jacgoudsmit/Propeddle/Hardware/Kicad/Plot/Schematic.pdf

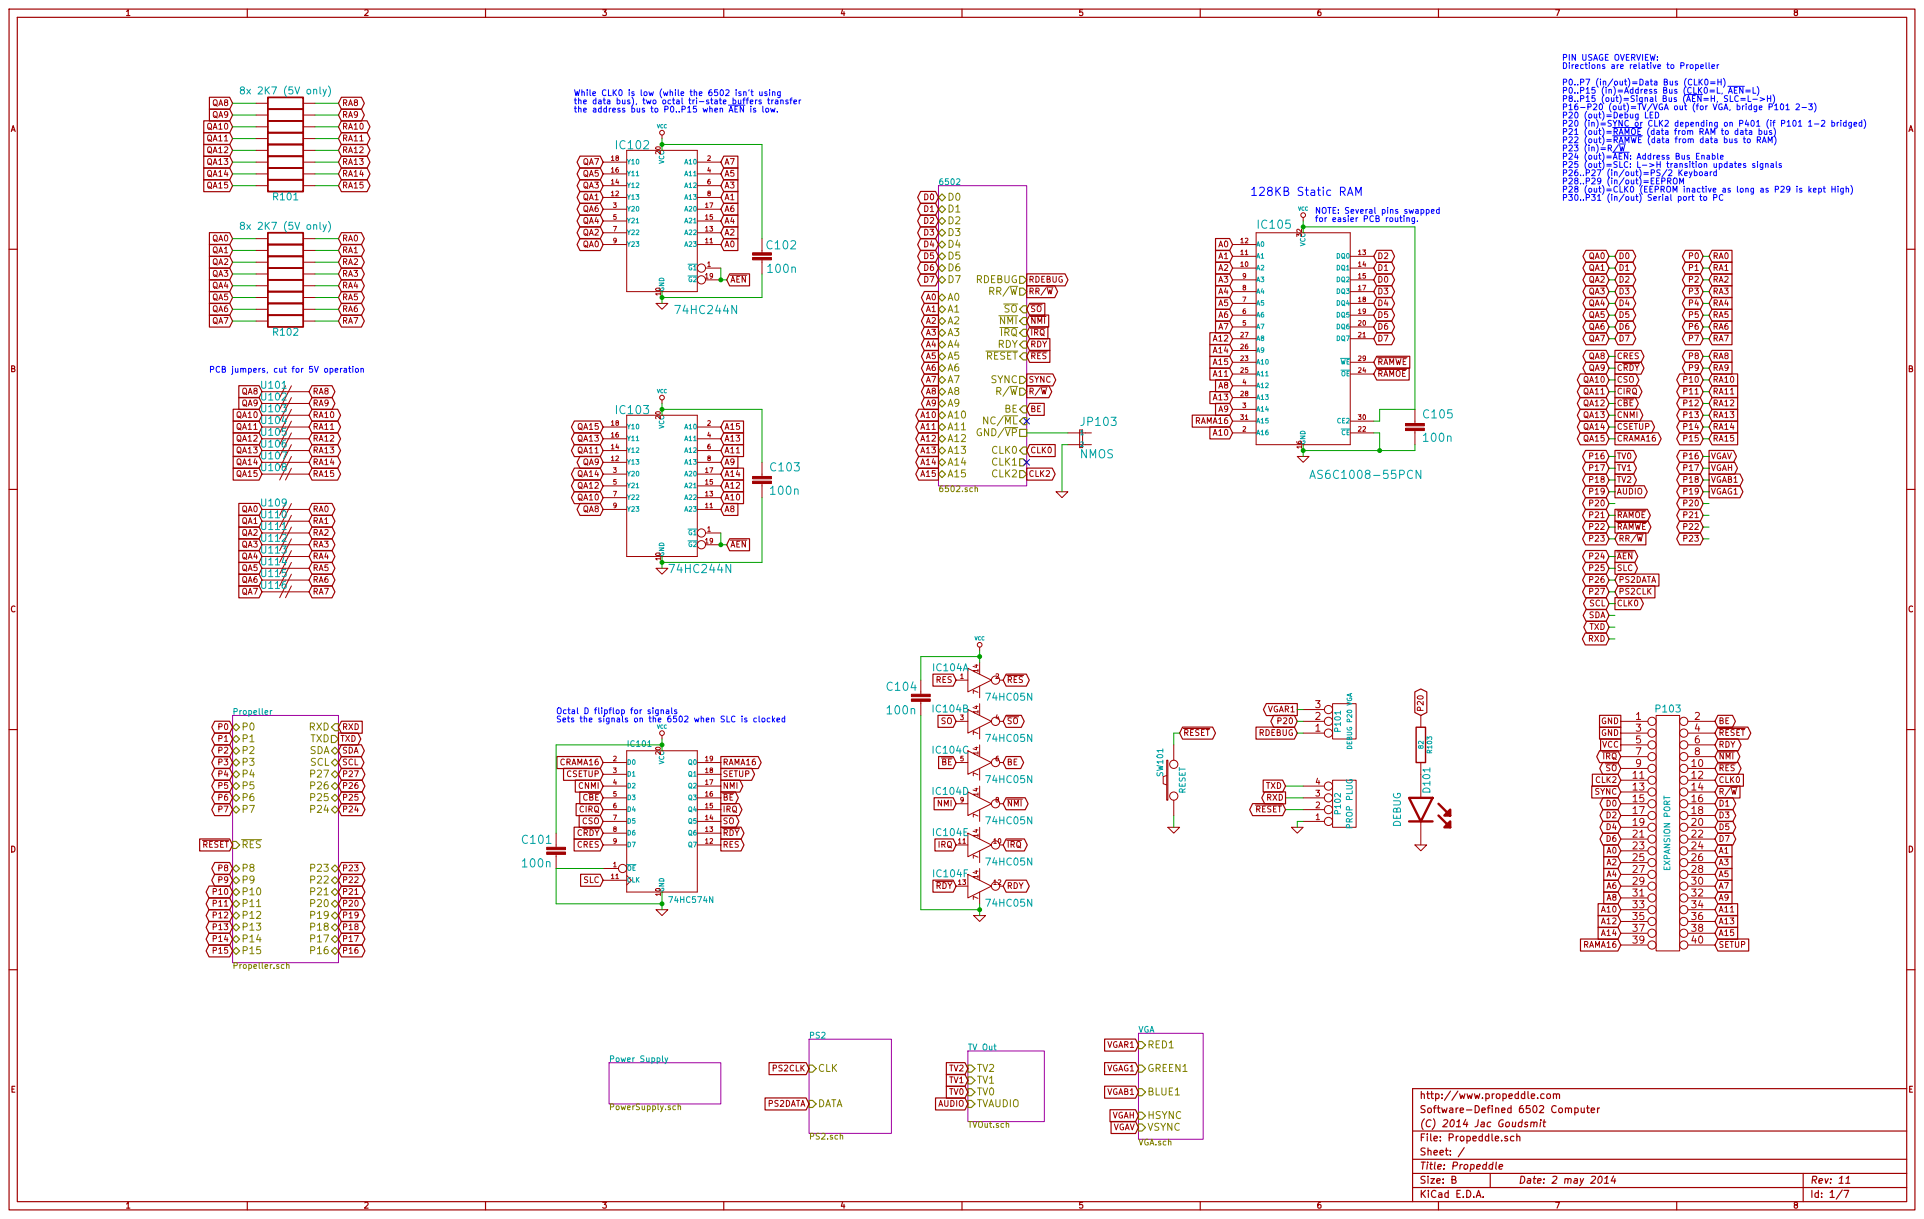
[picture p1: page 1]

P0..P7 (in/out)=Data Bus (CLK0=H)
P0..P15 (in)=Address Bus (CLK0=L, AEN=L)
P8..P15 (out)=Signal Bus (AEN=H, SLC=L->H)
P16-P20 (out)=TV/VGA out (for VGA, bridge P101 2-3)
P20 (out)=Debug LED
P20 (in)=SYNC or CLK2 depending on P401 (if P101 1-2 bridged)
P21 (out)=RAMOE (data from RAM to data bus)
P22 (out)=RAMWE (data from data bus to RAM)
P24 (out)=AEN: Address Bus Enable
P25 (out)=SLC: L->H transition updates signals
P26..P27 (in/out)=PS/2 Keyboard
P28..P29 (in/out)=EEPROM
P28 (out)=CLK0 (EEPROM inactive as long as P29 is kept High)

While CLK0 is low (while the 6502 isn't using
the data bus), two octal tri-state buffers transfer
the address bus to P0..P15 when AEN is low.

P30..P31 (in/out) Serial port to PC
D0 D1 D2 D3 D4 D5 D6 D7 QA8 QA9 QA10 QA11 QA12 QA13 QA14 QA15 P16 P17 P18 P19 P20 P21 P22 P23 P24 P25 P26 P27 SCL SDA

VCC
NOTE: Several pins swapped

RDEBUG
NMI SO
NC/ML BE RESET RDY

PCB jumpers, cut for 5V operation

Octal D flipflop for signals
Sets the signals on the 6502 when SLC is clocked

TV Out TVOut.sch TV2 TV1 TV0 TVAUDIO

http://www.propeddle.com
Software-Defined 6502 Computer
(C) 2014 Jac Goudsmit
File: Propeddle.sch
Sheet: /
Title: Propeddle
KiCad E.D.A.

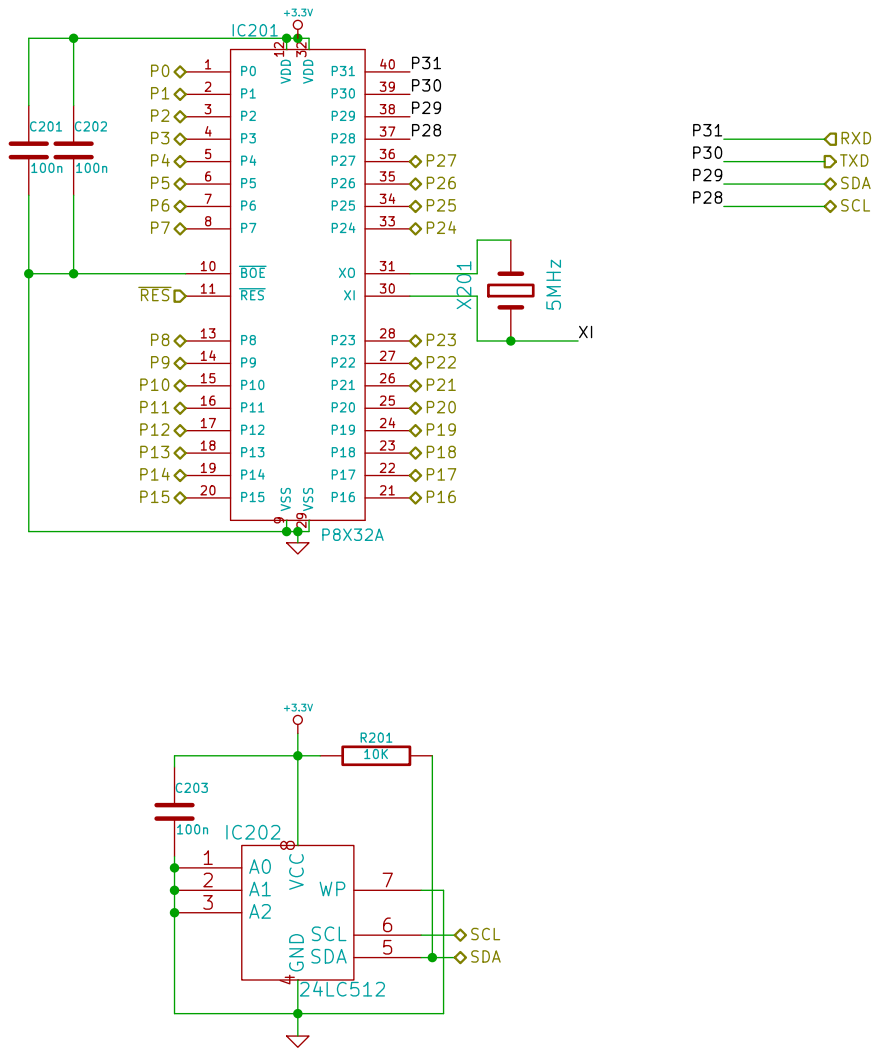
[picture p2: page 2]

http://www.propeddle.com
Software-Defined 6502 Computer
(C) 2014 Jac Goudsmit
File: Propeller.sch
Sheet: /Propeller/
Title: Propeddle

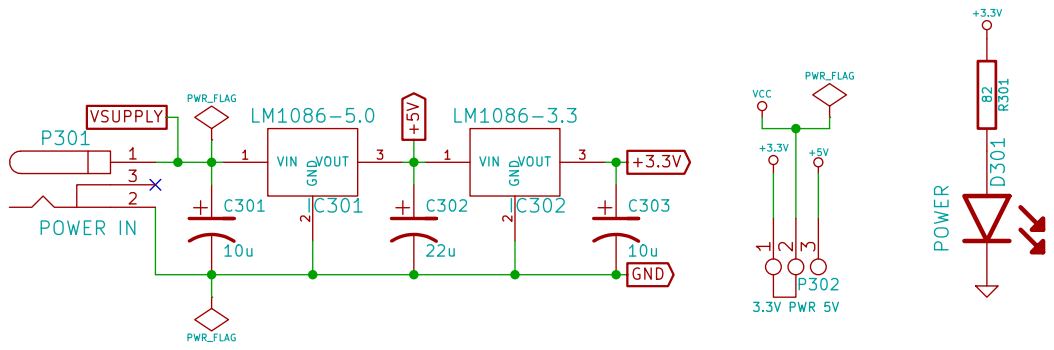
[picture p3: page 3]

http://www.propeddle.com
Software-Defined 6502 Computer
(C) 2014 Jac Goudsmit
File: PowerSupply.sch
Sheet: /Power Supply/
Title: Propeddle

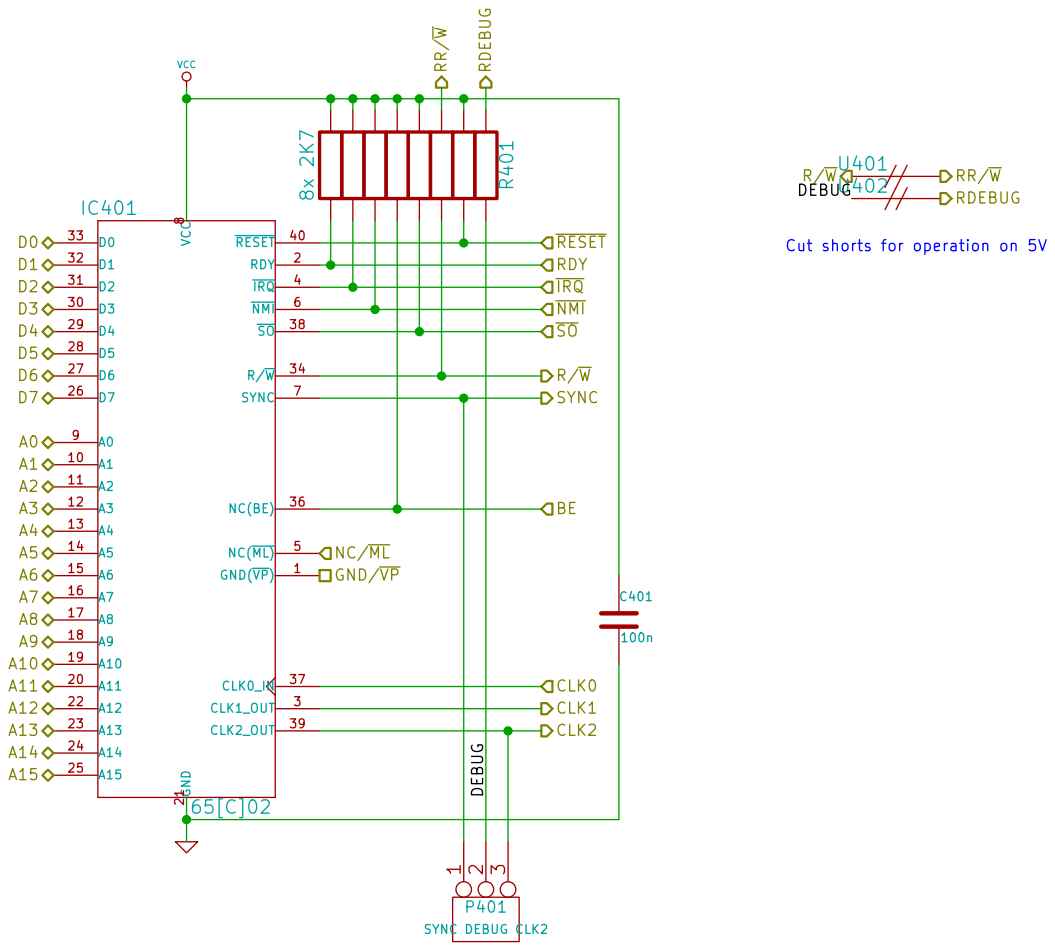
[picture p4: page 4]

Cut shorts for operation on 5V DEBUG

http://www.propeddle.com
Software-Defined 6502 Computer
(C) 2014 Jac Goudsmit
Title: Propeddle File: 6502.sch Sheet: /6502/

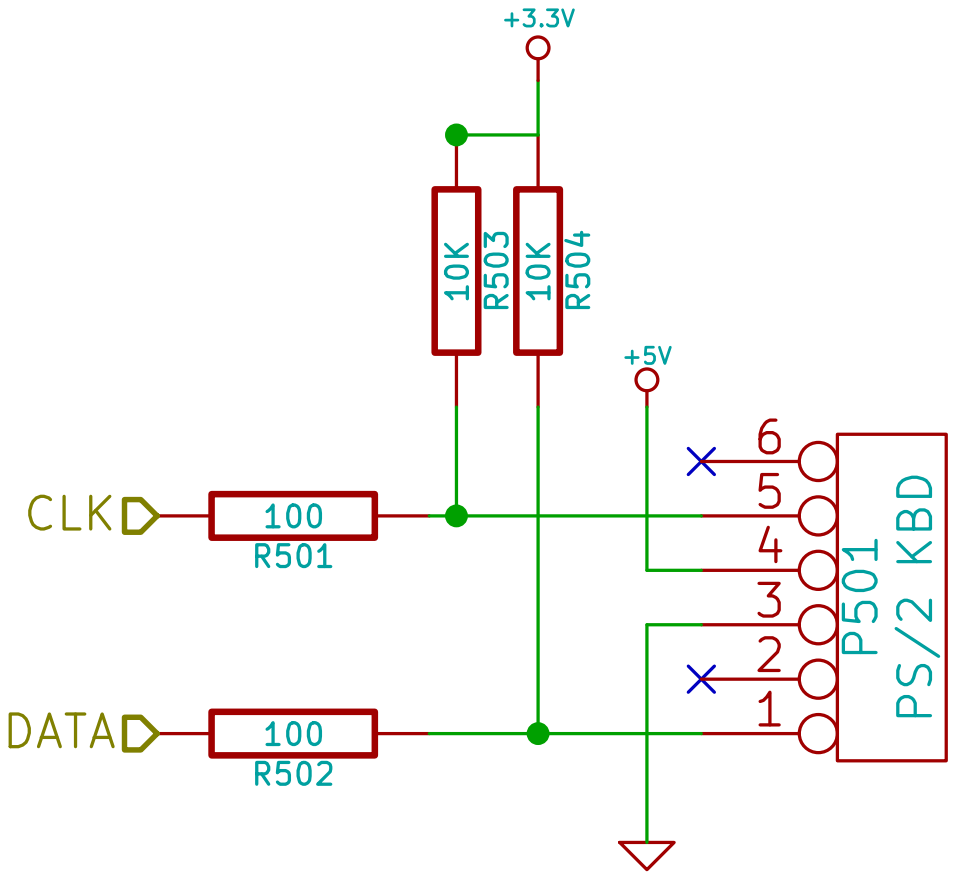
[picture p5: page 5]

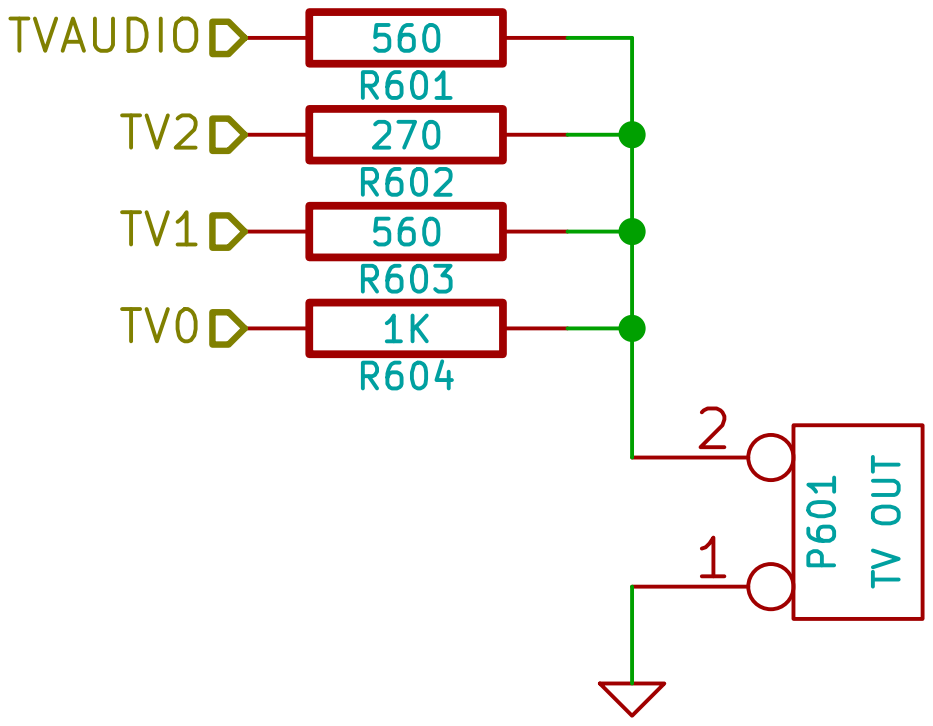
[picture p6: page 6]

http://www.propeddle.com
Software-Defined 6502 Computer
(C) 2014 Jac Goudsmit
File: TVOut.sch
Sheet: /TV Out/
Title: Propeddle

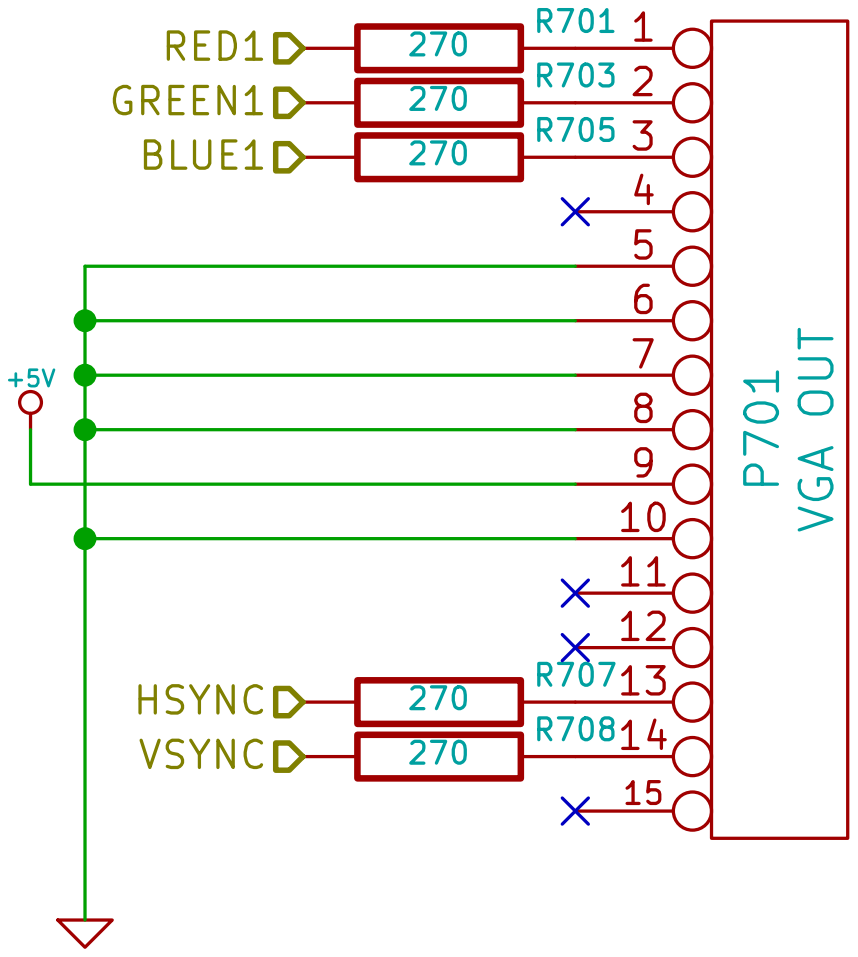
[picture p7: page 7]

http://www.propeddle.com 123456789
270 RED1 GREEN1 BLUE1 HSYNC
