jacgoudsmit/Propeddle/Hardware/Kicad/ENG_CD_1825027_G4.pdf

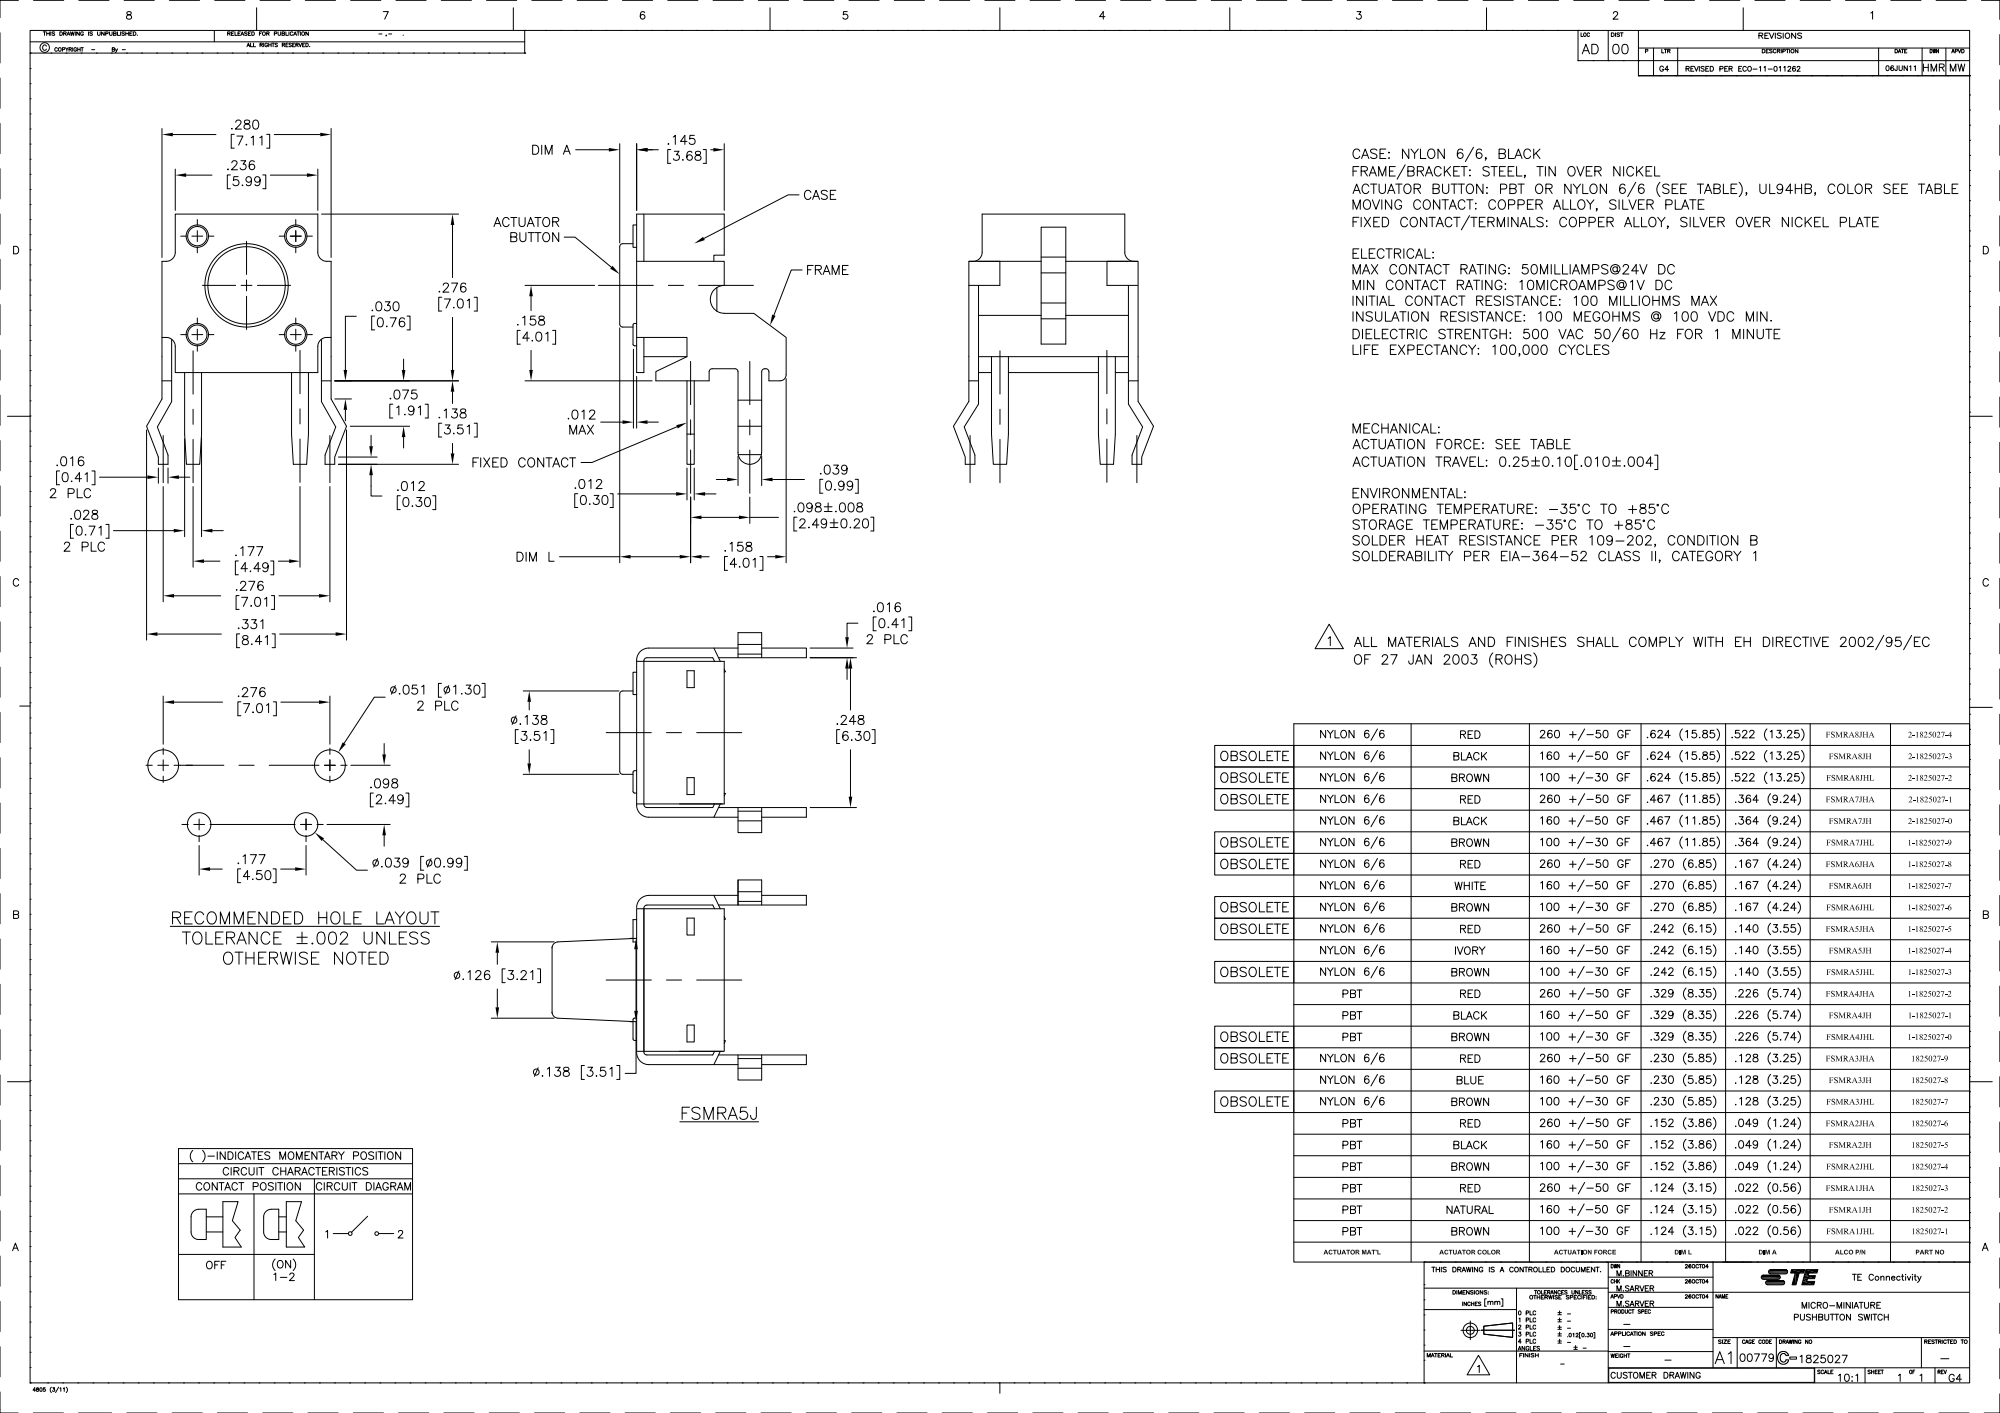
[picture p8: page 1]
