jacgoudsmit/Propeddle/Hardware/Kicad/Plot/PCB1.pdf

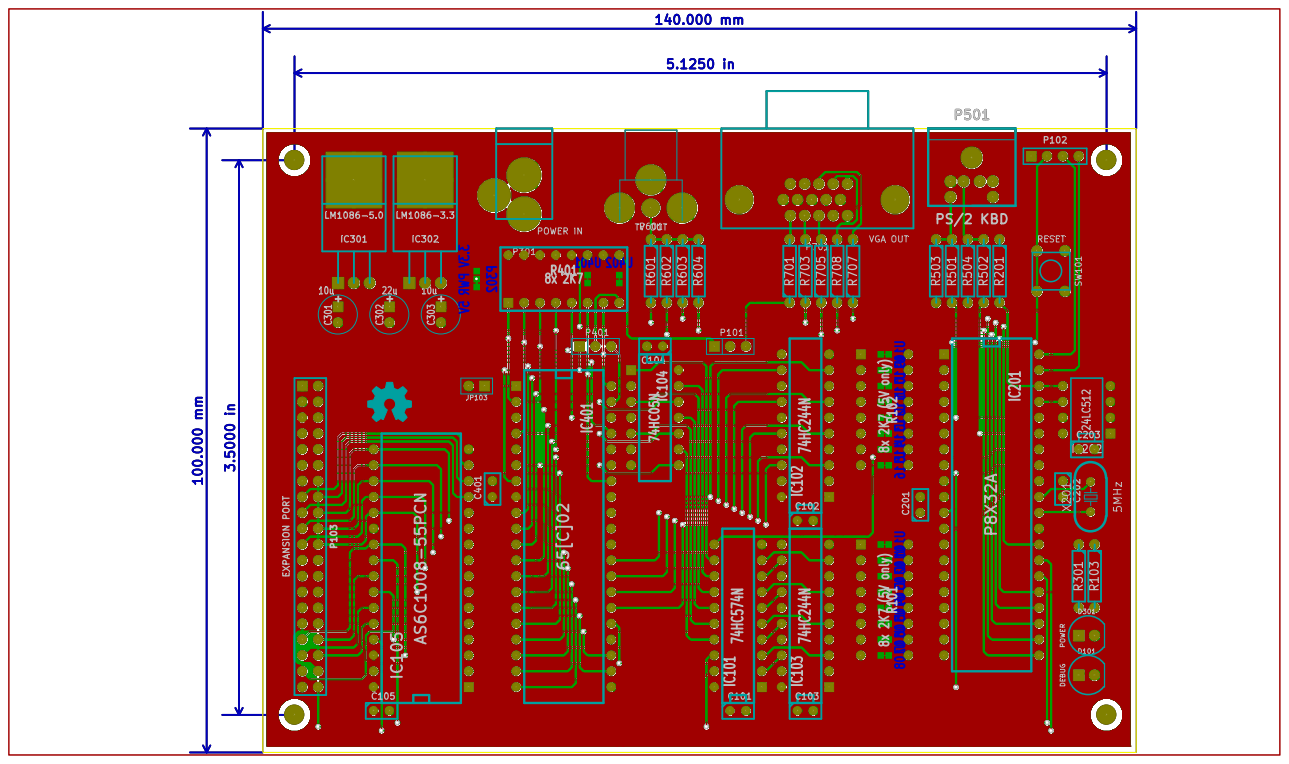
[picture p16: page 1]
