jacgoudsmit/Propeddle/Software/propeddle100.cfg

# propeddle100.cfg
    clkfreq: 100000000
    clkmode: XTAL1+PLL16X
    baudrate: 115200
    rxpin: 31
    txpin: 30
    tvpin: 16   # only used if TV_DEBUG is defined
