jacgoudsmit/Propeddle/(commit log)

2012-08-11 Starting rewrite of Propeddle software in C using SimpleIDE 0.8.3.
    The current implementation declares (pretty much) the (entire) API in the propeddle.h file but only implements the LED functions for now.
    The current test program only blinks the LED, to test the control cog.
    [propeddle100.cfg, propeddle80.cfg]
2012-08-16 Bugfix: Adding code to set up a stack for the control cog
    [p6502control.h, propeddle.c]
2012-08-16 Checking in some small bugfixes that I forgot to check in earlier
    [PropeddleTest.spin]
2013-03-09 Committing (non-working) changes before switching back to Spin
    The reason I'm abandoning the C version of the project for now, is that
    a lot of inline assembly code (such as a lot of instructions in the
    .cogc module) currently don't get compiled/assembled correctly: The
    assembler doesn't translate immediate values correctly if they refer to
    cog addresses (except for JMP / CALL instructions for which it follows a
    different execution path).
    Also, data directives that store pointers to other items in th same cog
    currently don't generate the correct addresses.
    The problem is caused by the fact that the GNU tools insist on using
    byte-based addressing, and the current version of the Propeller
    as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
    [main.c, p6502control.c, p6502control.h, p6502features.h, propeddle.c, propeddle.h]
2013-06-28 Adding updated Spin code
    This version of the Spin source code now includes all the modules that
    are needed, they just need to be "tied together". The demo application
    still controls the 6502 via spin and basically shows what I had at the
    2013 Bay Area Maker Faire Bring-a-hack dinner. But in theory there
    should be enough there now to use the Hub module to map the demo code
    and the video buffer, the Trace buffer to show what's going on, and the
    Control module to single-step or run the demo code. The RAM module
    should also be usable but nothing is tested yet. This is getting really
    close to being able to running at full speed!
2013-06-28 Updating the C code
    The C code depends on the new .pasm directive in the GCC compiler and it
    looks like it compiles correctly, but because the .pasm directive is
    experimental in the Propeller GCC compiler, there's a good chance that
    code gets compiled incorrectly even though it's logically correct. For
    now I don't want to deal with the possible debugging issues that might
    be involved with that, so I'll just check this in by way of archiving
    it. The most up-to-date software will be in the software/spin directory
    from this point on. Once I get the spin/pasm based code to work
    reliably, I will translate it to C/pasm again, for the purpose of
    generating code that's more flexible (because C has a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
    [demo.c, main.c, p6502_control.h, p6502_feature.h, p6502_hw.h, p6502control.c, p6502control.h, propeddle.c]
2013-07-02 IT RUNS!
    Got the PASM code running but have to deal with some timing problem: At
    80 cycles, the hub access and trace cogs apparently pick up the address
    bus too late or too early, seeing FDF0 instead of FFF0. At 88 cycles it
    works fine. At values in between, the loop runs out of time (hangs) so
    the code needs to be slightly more complicated that just taking 80 as
    minimum and allowing all values that are greater.
    At 88 cycles or higher, this works! Using this configuration, the test
    program tests the control cog, the hub access cog and the trace cog. It
    also tests that the 6502 accesses the RAM chip in read and write mode
    correctly.
    The timing problem can probably be fixed by using a cog time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
    [PropeddleTest.spin]
2013-07-07 Partial fix for timing of initial loop in Control module
    Instead of jumping into the middle of the loop and trying to get the
    timing right for the first loop, the code now falls through to the
    WAITCNT at the beginning of the loop, and makes sure that the cog is
    synchronized to the hub. Now at least the code doesn't freeze up when
    it's set to 80 cycles and all control cog loops should have the exact
    same timing if the cycle time is a multiple of 16, but I still have to
    set up my logic analyzer to find out why I'm getting completely wrong
    trace data at 80 cycles, while at 88 cycles, everything appears to work
    as expected...
    [PropeddleTest.spin]
2014-02-20 Checking in Kicad schematic
    Generated Kicad schematic with eagle2kicad.ulp from the circuitbee
    website, after modifying the ulp script so that g_Fact is set to 254*32
    instead of 254 (based on a tip from a web page called "unit issue with
    eagle2kicad.ulp"
    [Propeddle.sch]
2014-02-20 Kicad schematics
    Let's try that again, somehow all the parts got mangled on the previous
    version.
    [Propeddle.sch]
2014-02-23 Adding .gitignore in Kicad directory
2014-02-23 Some work on the hardware design in Kicad
    Eliminated a number of errors in schematic; created module for expansion
    port, other changes
    [Propeddle.kicad_pcb, Propeddle.sch]
2014-02-24 More updates to schematic
    I decided to keep working on the schematic and PCB layout in Kicad until
    I have the current schematic (Rev. 8A which needed a Propeller Platform
    motherboard and a modified VGA/AV module) implemented as Kicad files,
    and it completely matches what I have in Eagle. After that, I'll take
    the next step which is to design a new PCB with all the necessary
    hardware. That way, I can learn Kicad and focus on problems caused by
    the imperfect export script that I used to convert the Eagle design.
    Debugging things like short-circuits caused by Kicad interpreting two
    bus connections in the same place in a different way than Eagle, is much
    easier when the schematic is small and fa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
    [Propeddle.dsn, Propeddle.kicad_pcb, Propeddle.sch]
2014-03-09 Re-created exact component placements from Eagle
    [Propeddle.kicad_pcb]
2014-03-16 Finished re-designing Propeddle Rev.8A PCB
    The Kicad PCB design is now virtually identical to the Rev. 8 PCB that I
    sold as a kit, except the one missing trace on that PCB is now present.
    [Propeddle.kicad_pcb, Propeddle.sch]
2014-04-08 Completed design of "all-in-one" schematic/PCB
    Some of the important changes:
    - Everything on one PCB including Propeller, connectors and power
    supply. The only thing missing is the serial-to-USB converter.
    - Added inverters: the signals (~IRQ, ~NMI, ~RES, ~SO and RDY) are now
    connected via open-drain inverters which eliminates all diodes in the
    old schematic.
    - The old SEL0 and SEL1 are now replaced by BE (via open-drain inverter)
    and SETUP. These signals will make it possible to initialize expansion
    hardware via the data bus.
    - Added power supply, Propeller, connectors for keyboard, mouse, TV and
    power (and added their documentation)
    - The expansion port was redesigned (Sorry, future expan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
    [6502.sch, PS2.sch, PowerSupply.sch, Propeddle.dsn, Propeddle.kicad_pcb, Propeddle.sch, Propeller.sch, TVOut.sch]
2014-04-18 Schematic updates
    [6502.sch, PS2.sch, PowerSupply.sch, Propeddle.kicad_pcb, Propeddle.sch, Propeller.sch, TVOut.sch, VGA.sch]
2014-04-18 Schematic Rev. 11
    Added LEDs; some minor other modifications
    [6502.sch, PS2.sch, PowerSupply.sch, Propeddle.kicad_pcb, Propeddle.sch, Propeller.sch, TVOut.sch, VGA.sch]
2014-04-23 Schematic Rev. 11 update
    Replaced 74HC06N by 74HC05N
    [6502.sch, PS2.sch, PowerSupply.sch, Propeddle.kicad_pcb, Propeddle.sch, Propeller.sch, TVOut.sch, VGA.sch]
2014-04-23 SerInTVOut bugfix
    The FullDuplexSerial rxcheck function checks for an incoming character
    and removes it from the queue, the code assumed that it did the same as
    the PS/2 keyboard code so the user had to type everything twice when
    using the terminal.
    [SerInTVOut.spin]
2014-04-23 PCB Rev. 11
    Adjusted location of labels on big chips
    [Propeddle.kicad_pcb]
2014-04-26 Updated software to support hardware Rev. 11
    Currently only the Spin version of the demo program works, the control
    cog apparently doesn't.
    [PropeddleHardware.spin, PropeddleTest.spin]
2014-04-26 Fixed control cog to work on hardware Rev. 11
    And guess what... with my current wire-wrap setup on a Parallax USB
    Proto Board, I can run the main loop at 80 cycles now! (With the Rev. 8
    hardware, the program worked at 88 cycles (909kHz) but not at 80 cycles
    (1MHz).
    [PropeddleTest.spin]
2014-05-02 Moving databus behind resistors
    Checked and rewrote pin overview text, added some text to clarify top
    level schematic, and most importantly, moved the databus to the VCC side
    (not 3.3V) of the resistor packs.
    [6502.sch, PS2.sch, PowerSupply.sch, Propeddle.kicad_pcb, Propeddle.sch, Propeller.sch, TVOut.sch, VGA.sch]
2014-05-04 Fixed timing bug in Trace cog
    I forgot that when copying the system counter to a variable, CNT is
    copied at the SECOND cycle, not the first cycle. This threw the timing
    off by one cycle, which made it pick up the data bus value one cycle too
    late if the system is running at 80 cycles; also when that happens it
    misses a deadline to pick up the next cycle's tracing information and
    everything goes haywire.
2014-05-18 Some minor bug fixes to SerInTVOut
    More fixes related to the fact that I didn't grok earlier that checking
    for available input works different on the serial port than on the TV
    module. Also updated .gitignore to ignore automatically saved files from
    Kicad
    [SerInTVOut.spin]
2014-05-19 Change frequency to 100MHz, Add terminal module
    I realized that now the Propeller circuit is part of the kit, I'm not
    limited to 80MHz anymore so I'm free to change the BOM so it uses a
    6.25MHz crystal instead of a 5MHz crystal which may give me a little
    more leeway in cases where timing is tight. From now on, the code will
    be tested with a 6.25MHz system (internal frequency 100MHz). The
    comments and code aren't completely adapted to the new standard yet.
    A new module was added that emulates the keyboard and display hardware
    of the Apple 1. The keyboard part hasn't been tested yet, but the test
    program in this commit demonstrates the output functionality: it
    repeatedly prints all printable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
    [PropeddleTest.spin]
2014-05-26 Fixed terminal code
    The sample program now works: characters typed in the terminal (at any
    speed as far as I can tell) are echoed back by the 6502.
    [PropeddleTest.spin]
2014-05-27 Re-adding AIGeneric driver
    The AIGeneric driver was downloaded from the Parallax Object Exchange
    (OBEX) at http://obex.parallax.com/object/139.
    My SerInTVOut driver uses it to allow input from the serial port and the
    PS/2 keyboard at the same time and output to the serial port and screen
    at the same time. At this time, I'm away from home so I can't test the
    PS/2 and video part; the serial communications work (115200,8,n,1).
    There is a know issue that when the serial port is not connected, the
    code thinks there are characters coming in continuously.
    [PropeddleTest.spin]
2014-06-10 Download code now working & many bug fixes
    [PropeddleTest.spin]
2014-07-26 Adding Kicad generated PDF and SVG output
2015-05-07 Fixing hub access cog to make JMP WC work
    Added a NOP instruction at the start of the assembly code to make sure that there's a 0 stored at location 0, which guarantees that JMP #Accessloop WC works as advertised, and always sets the carry. For more info, see Issue 1.
    Thanks Marko Lukat (KoniMaru) for pointing this out!
